RabidRabbit2019/quaz/README.md

# quaz
test project, based on bluepill board
