RabidRabbit2019/quaz/quaz_amp_part/report.txt

Заменить посад.место C7 с 'Capacitor_Tantalum_SMD:CP_EIA-3528-21_Kemet-B_Pad1.50x2.35mm_HandSolder' на 'Capacitor_Tantalum_SMD:CP_EIA-6032-28_Kemet-C_Pad2.25x2.35mm_HandSolder': OK
