RabidRabbit2019/quaz/quaz_btn_part/quaz_btn_part.kicad_pcb

## KiCad design quaz_btn_part/quaz_btn_part.kicad_pcb (2024-06-14)

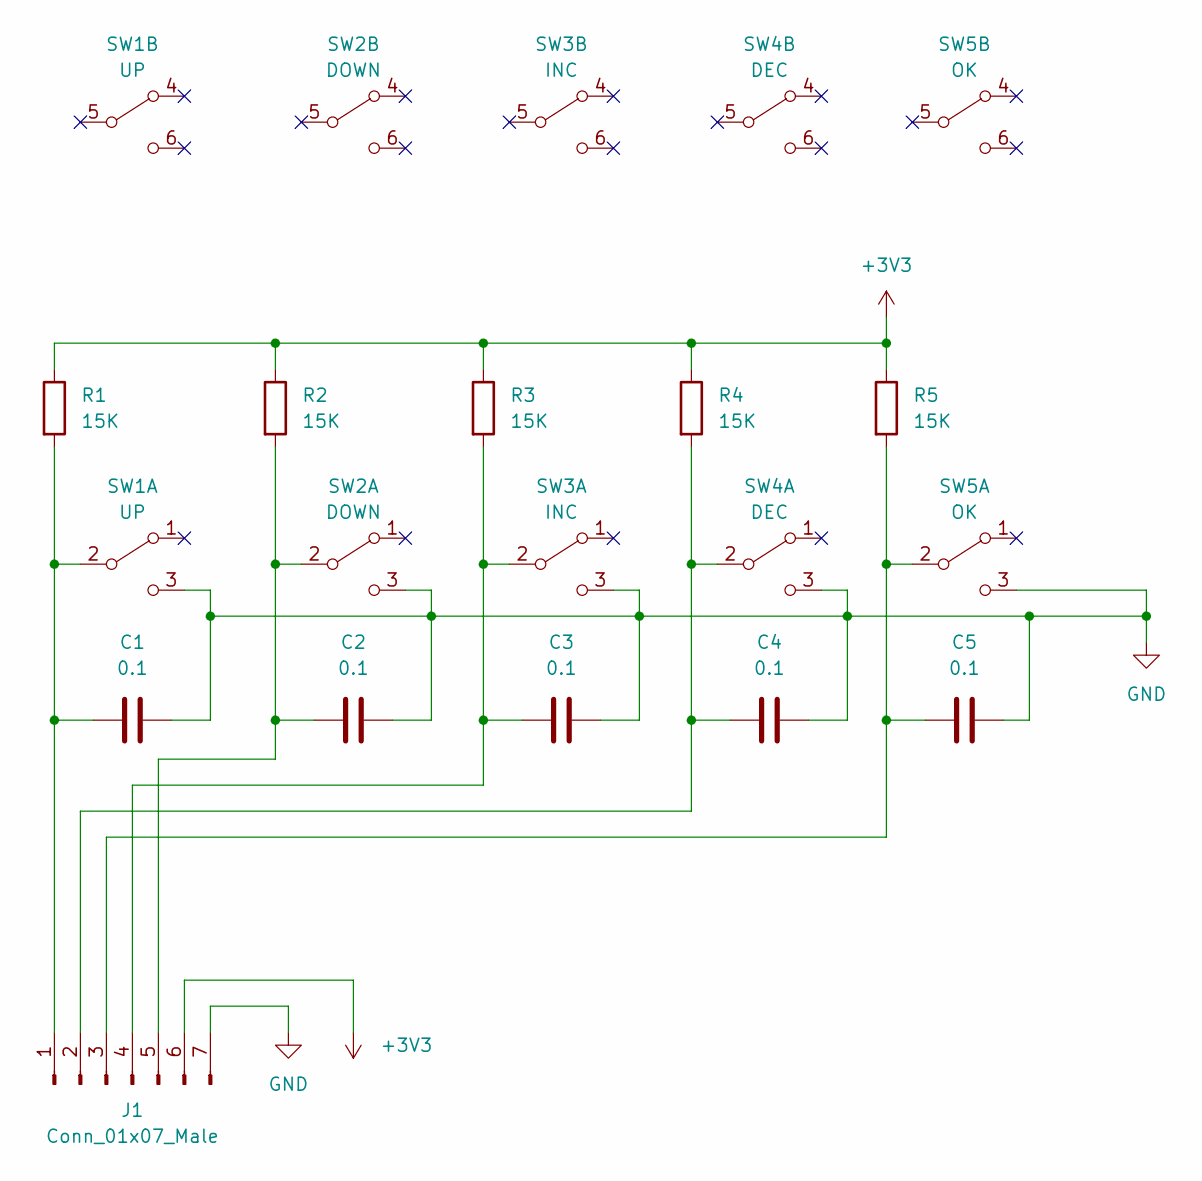
[picture p1: schematic quaz_btn_part.kicad_sch]

Parts:
C1, C2, C3, C4, C5: 0.1; C_1206_3216Metric_Pad1.33x1.80mm_HandSolder
J1: Conn_01x07_Male; PinHeader_1x07_P2.54mm_Vertical
R1, R2, R3, R4, R5: 15K; R_1206_3216Metric_Pad1.30x1.75mm_HandSolder
SW1: UP; BTN13
SW2: DOWN; BTN13
SW3: INC; BTN13
SW4: DEC; BTN13
SW5: OK; BTN13

Connections:
+3V3: J1.6, R1.1, R2.1, R3.1, R4.1, R5.1
GND: C1.2, C2.2, C3.2, C4.2, C5.2, J1.7, SW1.3 (C), SW2.3 (C), SW3.3 (C), SW4.3 (C), SW5.3 (C)
unnamed: C2.1, J1.5, R2.2, SW2.2 (B)
unnamed: C3.1, J1.4, R3.2, SW3.2 (B)
unnamed: C4.1, J1.2, R4.2, SW4.2 (B)
unnamed: C5.1, J1.3, R5.2, SW5.2 (B)
unnamed: C1.1, J1.1, R1.2, SW1.2 (B)

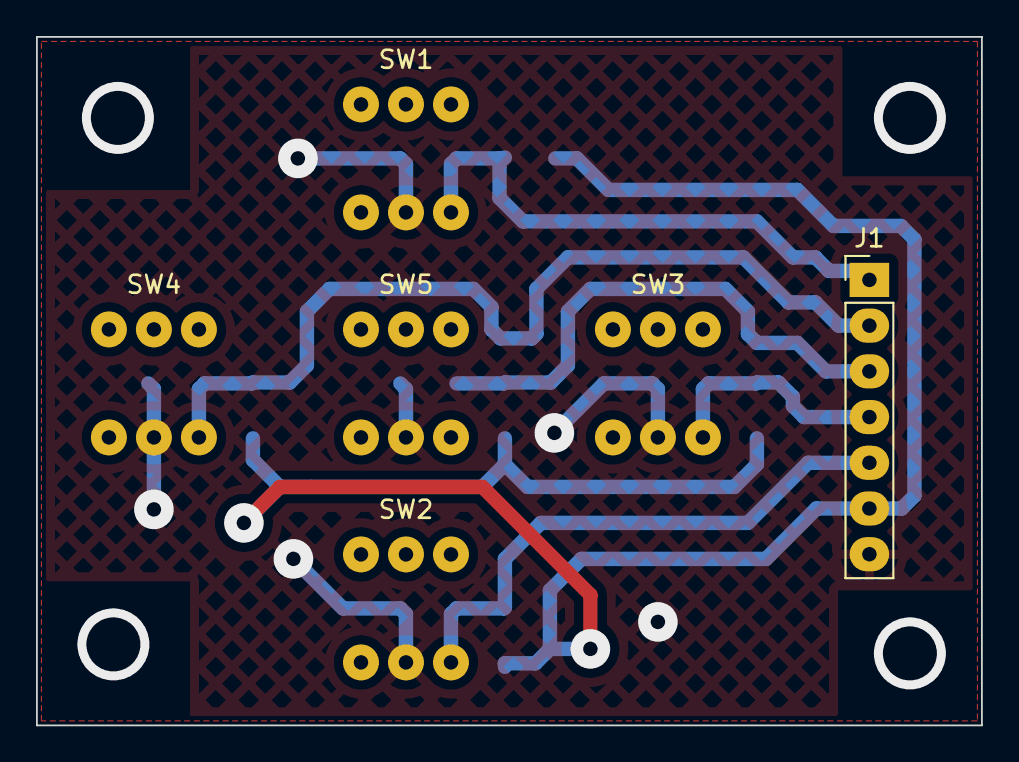
[picture p2: board quaz_btn_part.kicad_pcb from above]

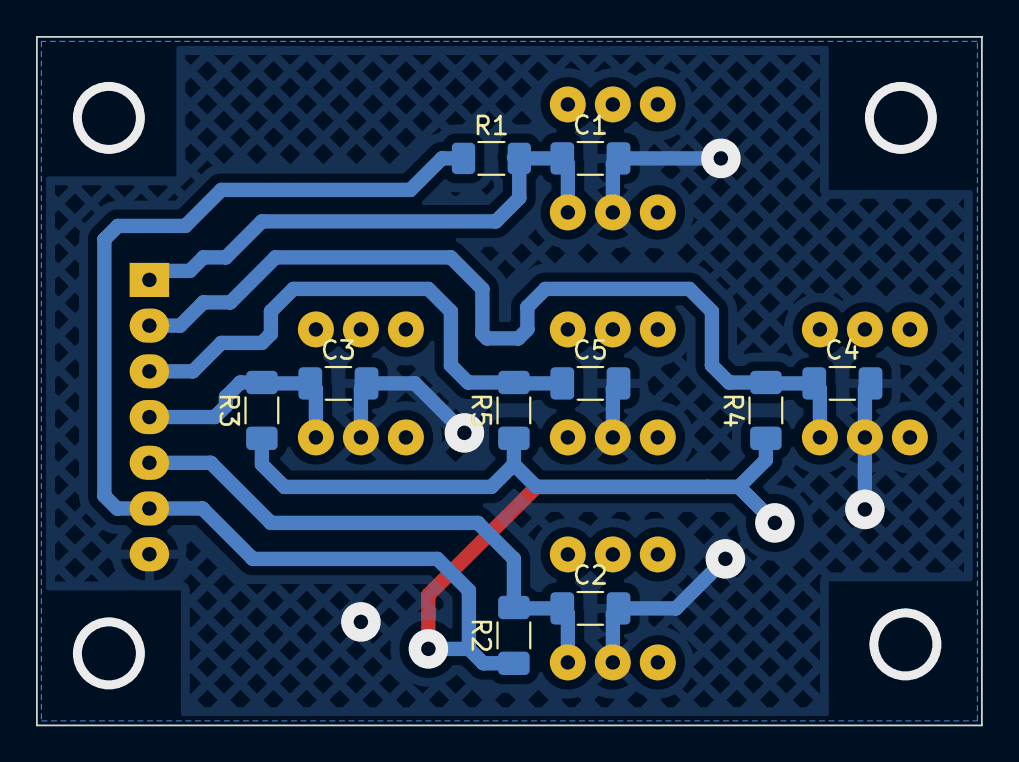
[picture p3: board quaz_btn_part.kicad_pcb from below]

Board: 2 copper layers, 52.5 x 38.2 mm, 16 parts (10 on the bottom side), 7 nets.
