RabidRabbit2019/quaz/quaz_drv_part/quaz_drv_part.kicad_pcb

## KiCad design quaz_drv_part/quaz_drv_part.kicad_pcb (2024-05-04)

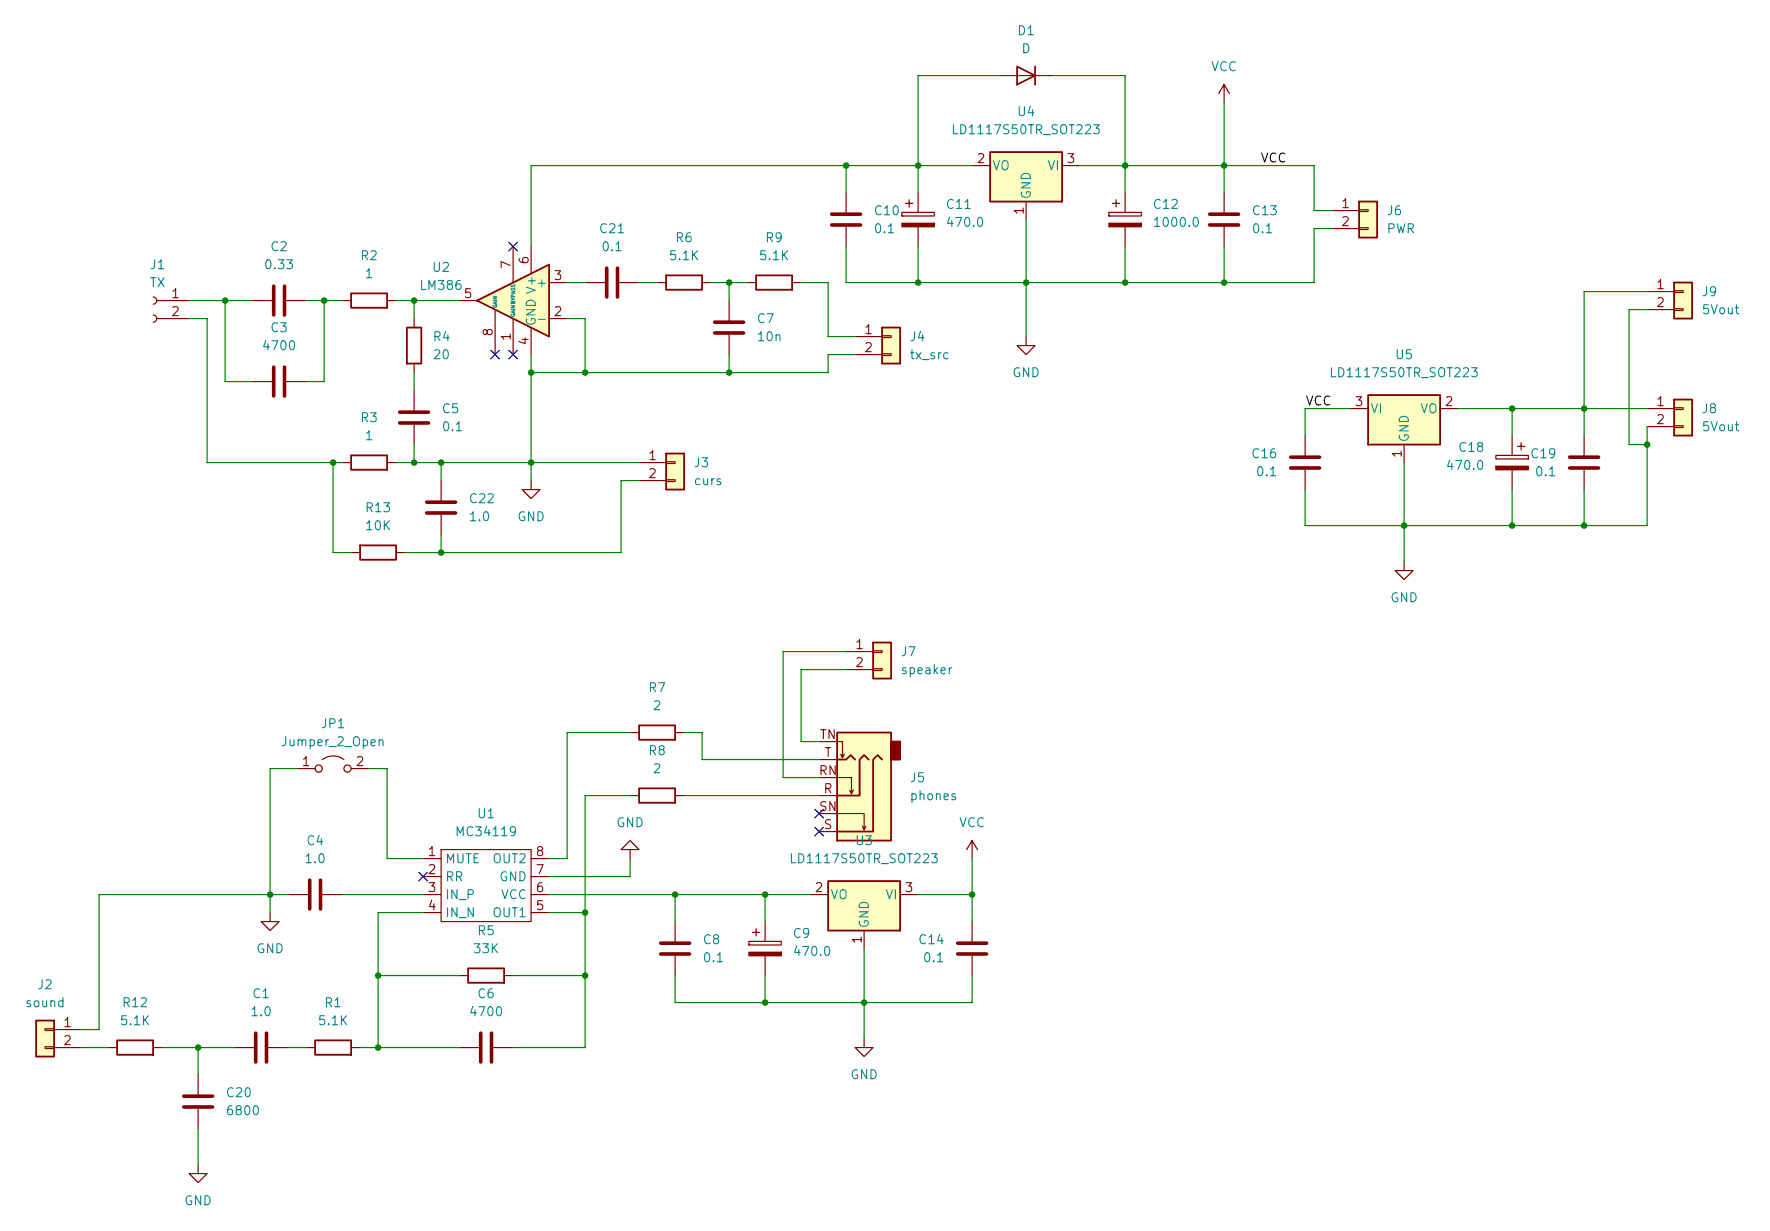
[picture p4: schematic quaz_drv_part.kicad_sch]

Parts:
C1, C4, C22: 1.0; C_1206_3216Metric_Pad1.33x1.80mm_HandSolder
C2: 0.33; C_Disc_D9.0mm_W5.0mm_P5.00mm
C3, C6: 4700; C_Disc_D9.0mm_W5.0mm_P5.00mm
C5, C8, C10, C13, C14, C16, C19, C21: 0.1; C_1206_3216Metric_Pad1.33x1.80mm_HandSolder
C7: 10n; C_Disc_D9.0mm_W5.0mm_P5.00mm
C9: 470.0; CP_Radial_D8.0mm_P5.00mm
C11, C18: 470.0; CP_Radial_D10.0mm_P5.00mm
C12: 1000.0; CP_Radial_D10.0mm_P5.00mm
C20: 6800; C_Disc_D9.0mm_W5.0mm_P5.00mm
D1: D; D_DO-41_SOD81_P5.08mm_Vertical_KathodeUp
J1: TX; PinHeader_1x02_P2.54mm_Vertical
J2: sound; PinHeader_1x02_P2.54mm_Vertical
J3: curs; PinHeader_1x02_P2.54mm_Vertical
J4: tx_src; PinHeader_1x02_P2.54mm_Vertical
J5: phones; Jack_6.35mm_Neutrik_NMJ6HCD3_Horizontal
J6: PWR; PinHeader_1x02_P2.54mm_Vertical
J7: speaker; PinHeader_1x02_P2.54mm_Vertical
J8, J9: 5Vout; PinHeader_1x02_P2.54mm_Vertical
JP1: Jumper_2_Open; PinHeader_1x02_P2.54mm_Vertical
R1, R6, R9, R12: 5.1K; R_1206_3216Metric_Pad1.30x1.75mm_HandSolder
R2, R3: 1; R_Axial_Power_L20.0mm_W6.4mm_P7.62mm_Vertical
R4: 20; R_Axial_DIN0207_L6.3mm_D2.5mm_P5.08mm_Vertical
R5: 33K; R_1206_3216Metric_Pad1.30x1.75mm_HandSolder
R7, R8: 2; R_1206_3216Metric_Pad1.30x1.75mm_HandSolder
R13: 10K; R_1206_3216Metric_Pad1.30x1.75mm_HandSolder
U1: MC34119; SOIC-8_3.9x4.9mm_P1.27mm
U2: LM386; DIP-8_W7.62mm
U3, U4, U5: LD1117S50TR_SOT223; SOT-223-3_TabPin2

Connections:
GND: C4.1, C5.2, C7.2, C8.2, C9.2, C10.2, C11.2, C12.2, C13.2, C14.2, C16.2, C18.2, C19.2, C20.2, C22.2, J2.1, J3.1, J4.2, J6.2, J8.2, J9.2, JP1.1 (A), R3.2, U1.7 (GND), U2.2 (-), U2.4 (GND), U3.1 (GND), U4.1 (GND), U5.1 (GND)
unnamed: C1.1, C20.1, R12.2
unnamed: C1.2, R1.1
unnamed: C2.1, C3.1, J1.1
unnamed: C2.2, C3.2, R2.1
unnamed: C4.2, U1.3 (IN_P)
unnamed: C5.1, R4.2
unnamed: C6.1, R5.2, R8.1, U1.5 (OUT1)
unnamed: C6.2, R1.2, R5.1, U1.4 (IN_N)
unnamed: C7.1, R6.1, R9.1
unnamed: C8.1, C9.1, U1.6 (VCC), U3.2 (VO)
unnamed: C10.1, C11.1, D1.2 (A), U2.6 (V+), U4.2 (VO)
unnamed: C18.1, C19.1, J8.1, J9.1, U5.2 (VO)
unnamed: C21.1, U2.3 (+)
unnamed: C21.2, R6.2
unnamed: C22.1, J3.2, R13.1
unnamed: J1.2, R3.1, R13.2
unnamed: J2.2, R12.1
unnamed: J4.1, R9.2
unnamed: J5.R, R8.2
unnamed: J5.RN, J7.1
unnamed: J5.T, R7.2
unnamed: J5.TN, J7.2
unnamed: JP1.2 (B), U1.1 (MUTE)
unnamed: R2.2, R4.1, U2.5
unnamed: R7.1, U1.8 (OUT2)
VCC: C12.1, C13.1, C14.1, C16.1, D1.1 (K), J6.1, U3.3 (VI), U4.3 (VI), U5.3 (VI)

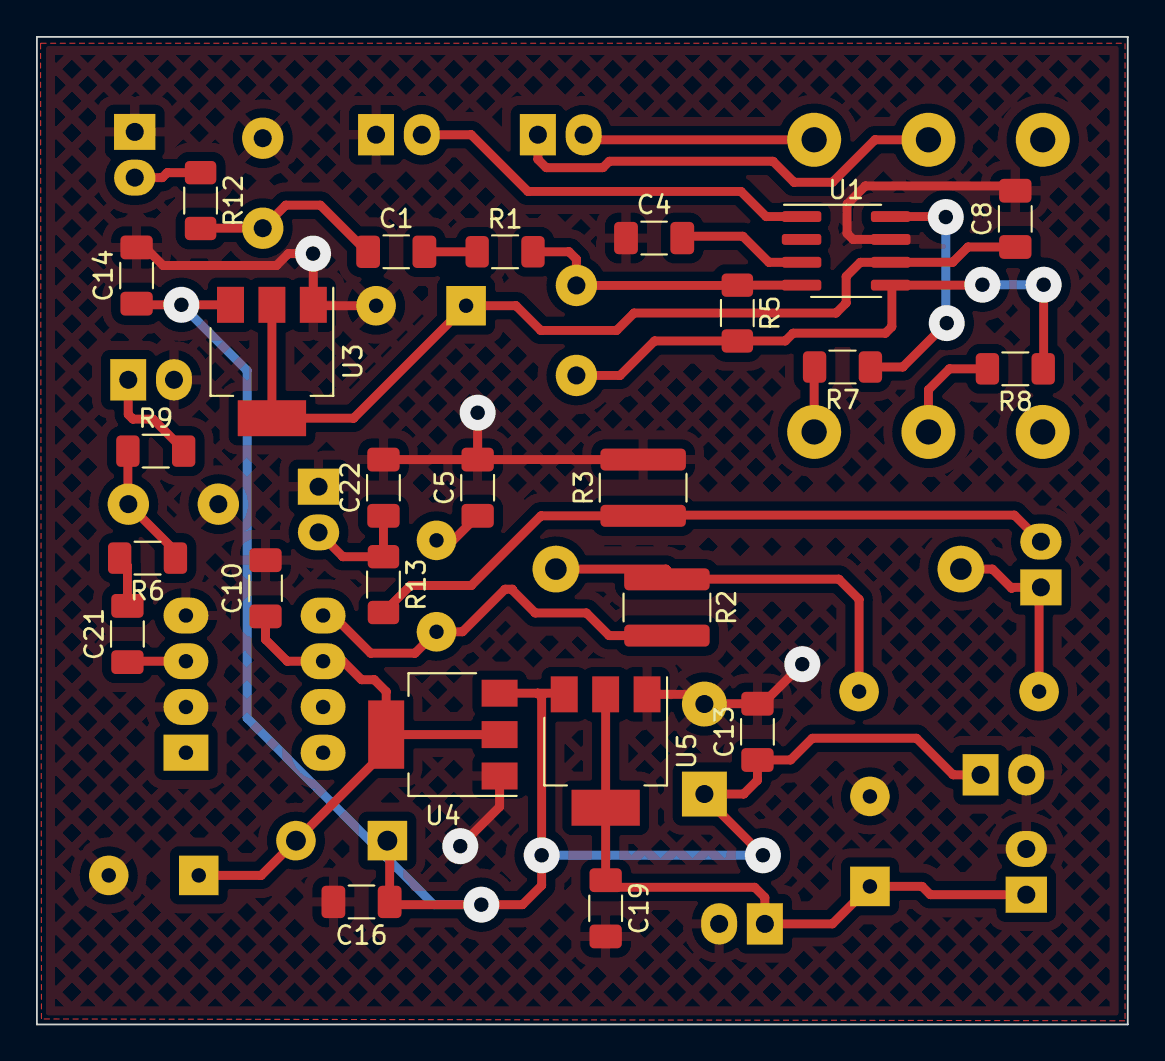
[picture p5: board quaz_drv_part.kicad_pcb from above]

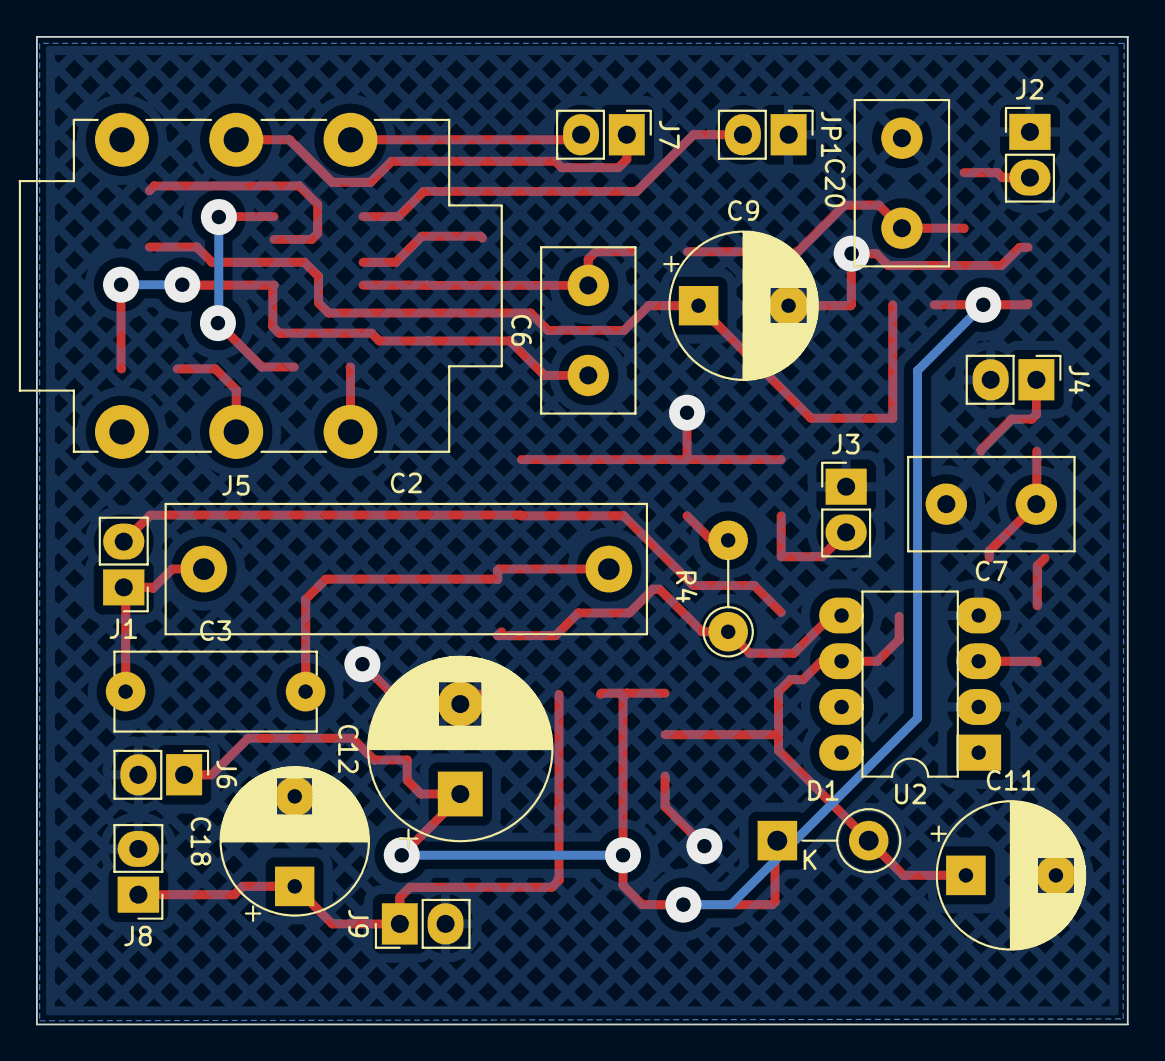
[picture p6: board quaz_drv_part.kicad_pcb from below]

Board: 2 copper layers, 60.6 x 54.9 mm, 47 parts (22 on the bottom side), 27 nets.
