RabidRabbit2019/quaz/quaz_amp_part/quaz_amp_part.kicad_pcb

## KiCad design quaz_amp_part/quaz_amp_part.kicad_pcb (2024-04-10)

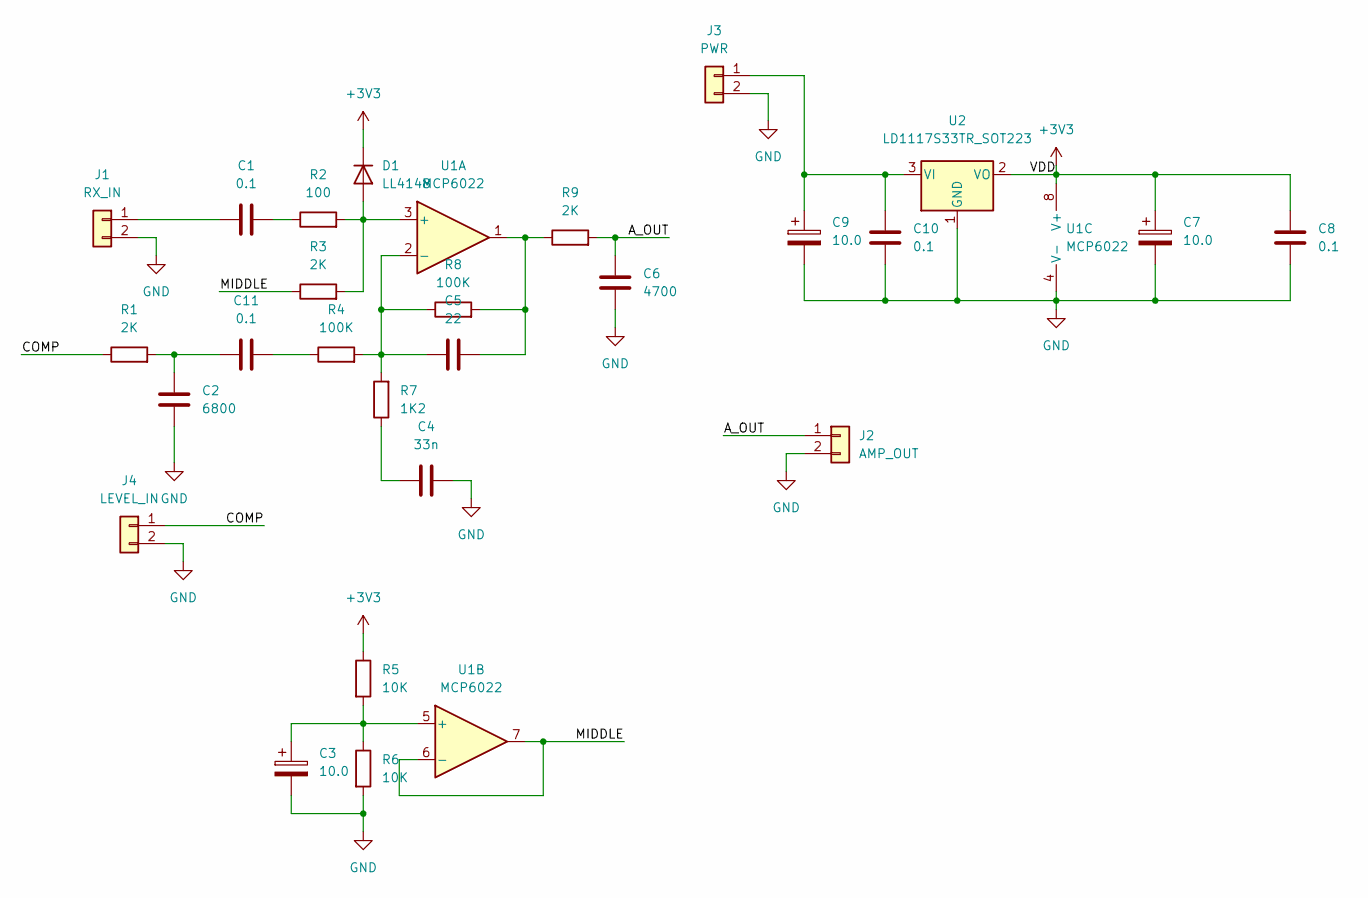
[picture p7: schematic quaz_amp_part.kicad_sch]

Parts:
C1, C8, C10, C11: 0.1; C_1206_3216Metric_Pad1.33x1.80mm_HandSolder
C2: 6800; C_Disc_D3.4mm_W2.1mm_P2.50mm
C3: 10.0; CP_EIA-7132-28_AVX-C_Pad2.72x3.50mm_HandSolder
C4: 33n; C_Disc_D8.0mm_W2.5mm_P5.00mm
C5: 22; C_Disc_D8.0mm_W2.5mm_P5.00mm
C6: 4700; C_Disc_D3.4mm_W2.1mm_P2.50mm
C7, C9: 10.0; CP_EIA-7132-20_AVX-U_Pad2.72x3.50mm_HandSolder
D1: LL4148; D_1206_3216Metric_Pad1.42x1.75mm_HandSolder
J1: RX_IN; PinHeader_1x02_P2.54mm_Vertical
J2: AMP_OUT; PinHeader_1x02_P2.54mm_Vertical
J3: PWR; PinHeader_1x02_P2.54mm_Vertical
J4: LEVEL_IN; PinHeader_1x02_P2.54mm_Vertical
R1, R3, R9: 2K; R_1206_3216Metric_Pad1.30x1.75mm_HandSolder
R2: 100; R_1206_3216Metric_Pad1.30x1.75mm_HandSolder
R4, R8: 100K; R_1206_3216Metric_Pad1.30x1.75mm_HandSolder
R5, R6: 10K; R_1206_3216Metric_Pad1.30x1.75mm_HandSolder
R7: 1K2; R_1206_3216Metric_Pad1.30x1.75mm_HandSolder
U1: MCP6022; SOIC-8_3.9x4.9mm_P1.27mm
U2: LD1117S33TR_SOT223; SOT-223-3_TabPin2

Connections:
+3V3: C7.1, C8.1, D1.1 (K), R5.1, U1.8 (V+), U2.2 (VO)
/A_OUT: C6.2, J2.1, R9.2
/COMP: J4.1, R1.1
/MIDDLE: R3.1, U1.6 (-), U1.7
GND: C2.2, C3.2, C4.2, C6.1, C7.2, C8.2, C9.2, C10.2, J1.2, J2.2, J3.2, J4.2, R6.2, U1.4 (V-), U2.1 (GND)
unnamed: C1.1, J1.1
unnamed: C1.2, R2.1
unnamed: C2.1, C11.1, R1.2
unnamed: C3.1, R5.2, R6.1, U1.5 (+)
unnamed: C4.1, R7.1
unnamed: C5.1, R4.2, R7.2, R8.1, U1.2 (-)
unnamed: C5.2, R8.2, R9.1, U1.1
unnamed: C9.1, C10.1, J3.1, U2.3 (VI)
unnamed: D1.2 (A), R2.2, R3.2, U1.3 (+)
unnamed: C11.2, R4.1

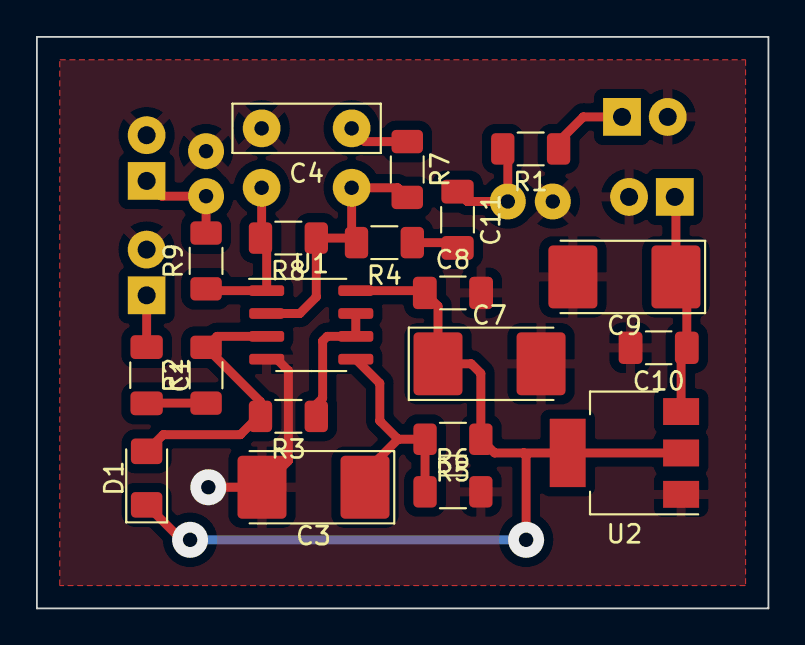
[picture p8: board quaz_amp_part.kicad_pcb from above]

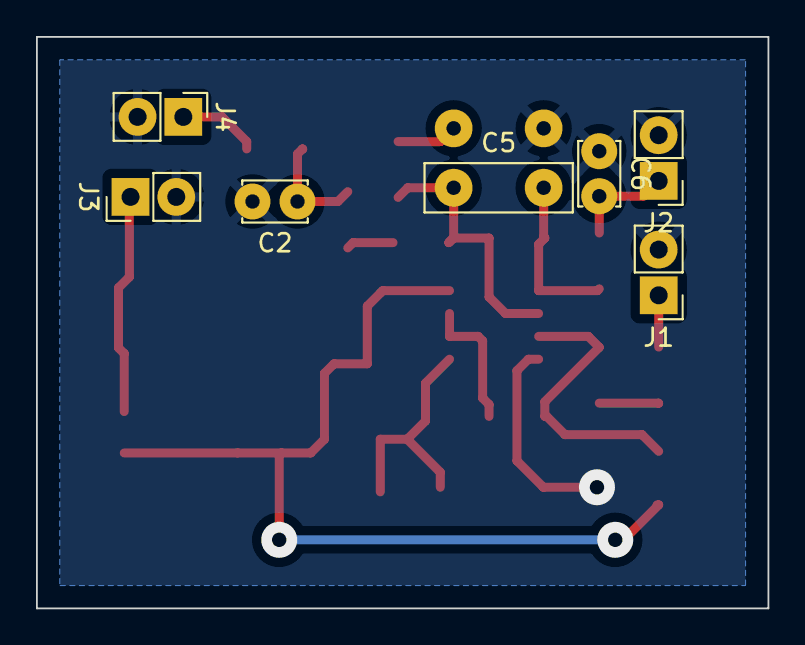
[picture p9: board quaz_amp_part.kicad_pcb from below]

Board: 2 copper layers, 40.6 x 31.8 mm, 27 parts (7 on the bottom side), 15 nets.
