RabidRabbit2019/quaz/src/gen_dds.c

#include "gen_dds.h"
#include "settings.h"
#include "stm32f103x6.h"


void delay_ms( uint32_t a_ms );

// dds генераторы для TX, компенсации разбаланса и звука

// ширина импульсов для косинуса, 256 уровней
static const uint8_t g_cos_table[1024] = {
128, 129, 130, 130, 131, 132, 133, 133,
134, 135, 136, 137, 137, 138, 139, 140,
140, 141, 142, 143, 144, 144, 145, 146,
147, 147, 148, 149, 150, 151, 151, 152,
153, 154, 154, 155, 156, 157, 157, 158,
159, 160, 160, 161, 162, 163, 164, 164,
165, 166, 167, 167, 168, 169, 169, 170,
171, 172, 172, 173, 174, 175, 175, 176,
177, 178, 178, 179, 180, 180, 181, 182,
183, 183, 184, 185, 185, 186, 187, 187,
188, 189, 189, 190, 191, 192, 192, 193,
194, 194, 195, 196, 196, 197, 198, 198,
199, 199, 200, 201, 201, 202, 203, 203,
204, 205, 205, 206, 206, 207, 208, 208,
209, 209, 210, 211, 211, 212, 212, 213,
214, 214, 215, 215, 216, 216, 217, 218,
218, 219, 219, 220, 220, 221, 221, 222,
222, 223, 224, 224, 225, 225, 226, 226,
227, 227, 228, 228, 229, 229, 229, 230,
230, 231, 231, 232, 232, 233, 233, 234,
234, 234, 235, 235, 236, 236, 237, 237,
237, 238, 238, 239, 239, 239, 240, 240,
240, 241, 241, 242, 242, 242, 243, 243,
243, 244, 244, 244, 245, 245, 245, 245,
246, 246, 246, 247, 247, 247, 248, 248,
248, 248, 249, 249, 249, 249, 250, 250,
250, 250, 250, 251, 251, 251, 251, 251,
252, 252, 252, 252, 252, 253, 253, 253,
253, 253, 253, 253, 254, 254, 254, 254,
254, 254, 254, 254, 255, 255, 255, 255,
255, 255, 255, 255, 255, 255, 255, 255,
255, 255, 255, 255, 255, 255, 255, 255,
255, 255, 255, 255, 255, 255, 255, 255,
255, 255, 255, 255, 255, 255, 255, 255,
255, 255, 255, 255, 255, 254, 254, 254,
254, 254, 254, 254, 254, 253, 253, 253,
253, 253, 253, 253, 252, 252, 252, 252,
252, 251, 251, 251, 251, 251, 250, 250,
250, 250, 250, 249, 249, 249, 249, 248,
248, 248, 248, 247, 247, 247, 246, 246,
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
};


// текущая фаза генератора TX
static uint32_t g_phase_tx = 0;
// текущая фаза генератора компенсации разбаланса
static volatile uint32_t g_phase_comp = 0;
// текущая фаза генератора звука
static uint32_t g_phase_sound = 0;
// уровень выходного сигнала TX [0..256]
static volatile uint32_t g_level_tx = 0;
// уровень выходного сигнала компенсации разбаланса [0..256]
static volatile uint32_t g_level_comp = 0;
// уровень громкости звука [0...256]
static volatile uint32_t g_level_sound = 0;
// частота (сдвиг фазы генератора) TX и сигнала компенсации
static uint32_t g_gen_freq = 0;
// частота (сдвиг фазы генератора) звука
static uint32_t g_sound_freq = 0;


uint32_t get_tx_phase() {
  return g_phase_tx;
}


uint32_t get_tx_freq() {
  return g_gen_freq;
}


void set_sound_freq_by_angle( uint32_t a_angle ) {
  g_sound_freq = 512u + (uint32_t)( ((((uint64_t)a_angle) * 10) << 32) / BASE_PWM_FREQ );
}


uint32_t get_tx_level() {
  return g_level_tx;
}


uint32_t get_cm_level() {
  return g_level_comp;
}


void set_tx_level( uint32_t a_level ) {
  if ( a_level > MAX_TX_LEVEL ) {
    a_level = MAX_TX_LEVEL;
  } else {
    if ( a_level < MIN_TX_LEVEL ) {
      a_level = MIN_TX_LEVEL;
    }
  }
  g_level_tx = a_level;
}


void set_cm_level( uint32_t a_level ) {
  if ( a_level > MAX_TX_LEVEL ) {
    a_level = MAX_TX_LEVEL;
  } else {
    if ( a_level < MIN_TX_LEVEL ) {
      a_level = MIN_TX_LEVEL;
    }
  }
  g_level_comp = a_level;
}


// установить громкость звука
void set_sound_volume( uint32_t a_volume ) {
  if ( a_volume > MAX_SOUND_VOLUME ) {
    a_volume = MAX_SOUND_VOLUME;
  } else {
    if ( a_volume < MIN_SOUND_VOLUME ) {
      a_volume = MIN_SOUND_VOLUME;
    }
  }
  g_level_sound = a_volume;
}


// изменить текущую фазу сигнала компенсации
void set_cm_phase( uint32_t a_phase_diff ) {
  // запоминаем текущую фазу генератора
  uint32_t v_phase = g_phase_comp;
  // ждём изменения фазы генератора (сгенерирован очередной отсчёт)
  while ( v_phase == g_phase_comp ) {}
  // меняем фазу генератора между отсчётами
  g_phase_comp += a_phase_diff;
}


// настройка таймера-1
// канал 1 - генерация "синуса" для TX
// канал 2 - генерация "синуса" для сигнала компенсации
// канал 3 - генерация "синуса" для звука
// настройка таймера-3 - генерация "пинков" для АЦП (cобытие сравнения 2 раза за период)
void gen_dds_init() {
  // настройки генераторов из профиля
  settings_t * v_profile = settings_get_current_profile();
  g_level_tx = v_profile->level_tx; // по базовой схеме ~60 мА
  g_level_comp = v_profile->level_comp;
  g_level_sound = v_profile->level_sound;
  g_gen_freq = v_profile->gen_freq;
  g_phase_comp = v_profile->phase_comp_start;
  // включаем выводы каналов CH1/PA8, CH2/PA9, CH3/PA11 таймера-1
  // alternate push-pull 2MHz
  GPIOA->CRH = (GPIOA->CRH & ~( GPIO_CRH_MODE8_Msk | GPIO_CRH_CNF8_Msk
                              | GPIO_CRH_MODE9_Msk | GPIO_CRH_CNF9_Msk
                              | GPIO_CRH_MODE10_Msk | GPIO_CRH_CNF10_Msk
                              ))
               | GPIO_CRH_MODE8_1  | GPIO_CRH_CNF8_1
               | GPIO_CRH_MODE9_1  | GPIO_CRH_CNF9_1
               | GPIO_CRH_MODE10_1 | GPIO_CRH_CNF10_1
               ;
  // настраиваем таймер-1
  // тактируется от APB2 без делителя (72МГц), двунаправленный счётчик, APR=256, период 512 тактов
  // ШИМ 8 битов (частота 72000000 / 512 = 140625). Update Event один раз за период, т.е. RCR=1
  // Output Trigger по включению таймера для одновременного запуска TIM3
  TIM1->PSC = 0; // без делителя
  TIM1->ARR = 256; // докуда считать
  TIM1->RCR = 1; // "делитель" частоты Update Event
  TIM1->CNT = 0; // на всяк случ сброс счётчика
  TIM1->CCR1 = g_cos_table[0]; // TX начинаем с нулевой фазы
  // сигнал компенсации по фазе от g_phase_comp, может быть прочитано из профиля и != 0
  // 1024 отсчёта - период "синусоиды", 2^32 - период фазы генератора (DDS)
  TIM1->CCR2 = g_cos_table[g_phase_comp >> 22];
  TIM1->CCR3 = g_cos_table[0]; // звук, с нулевой фазы, тут пофик
  // режимы сравнения для трёх каналов
  TIM1->CCMR1 = TIM_CCMR1_OC1M_1 | TIM_CCMR1_OC1M_2 | TIM_CCMR1_OC1PE
              | TIM_CCMR1_OC2M_1 | TIM_CCMR1_OC2M_2 | TIM_CCMR1_OC2PE
              ;
  TIM1->CCMR2 = TIM_CCMR2_OC3M_1 | TIM_CCMR2_OC3M_2 | TIM_CCMR2_OC3PE
              ;
  TIM1->CCER = TIM_CCER_CC1E
             | TIM_CCER_CC2E
             | TIM_CCER_CC3E
             ;
  TIM1->BDTR = TIM_BDTR_MOE
             | TIM_BDTR_OSSR
             ;
  TIM1->CR2 = TIM_CR2_MMS_0; // запуск таймера - событие TRGO
  TIM1->CR1 = TIM_CR1_CMS_0 | TIM_CR1_CMS_1
            | TIM_CR1_URS
            ;
  TIM1->SR = 0;
  TIM1->DIER = TIM_DIER_UIE;
  // настраиваем таймер-3 для пинания АЦП, тактирование 36 МГц (APB1 без делителя)
  // счёт вверх до 127 (0..127, 128 тактов), запуск синхронно со стартом TIM1
  TIM3->PSC = 0;
  TIM3->CR1 = TIM_CR1_URS;
  TIM3->CR2 = TIM_CR2_MMS_1;
  TIM3->ARR = 127;
  TIM3->CNT = 0;
  TIM3->SMCR = TIM_SMCR_SMS_1
             | TIM_SMCR_SMS_2
             ;
  // запускаем TIM1 и TIM3
  TIM1->CR1 |= TIM_CR1_CEN;
  __NVIC_EnableIRQ( TIM1_UP_IRQn );
  // генерируем Update Event, чтобы в "теневые" регистры попали текущие значения
  // а в буферные регистры легли новые значения (для следующего периода)
  // TIM1->EGR = TIM_EGR_UG;
}


void gen_dds_shutdown() {
  // отключаем прерывание от таймера
  __NVIC_DisableIRQ( TIM1_UP_IRQn );
  // отключаем таймер 3
  TIM3->CR1 = 0;
  // отключаем таймер 1
  TIM1->CR1 = 0;
  // сброс таймеров 1 и 3
  RCC->APB1RSTR = RCC_APB1RSTR_TIM3RST;
  RCC->APB2RSTR = RCC_APB2RSTR_TIM1RST;
  delay_ms( 2u );
  RCC->APB1RSTR = 0;
  RCC->APB2RSTR = 0;
  // начальные значения переменных
  g_phase_tx = 0;
  g_phase_comp = 0;
  g_phase_sound = 0;
  g_level_tx = 0;
  g_level_comp = 0;
  g_level_sound = 0;
  g_gen_freq = 0;
  g_sound_freq = 0;
}


// событие update таймера-1, обновляем регистры сравнения
// эти значения перепишутся в "теневые" регистры при следующем Update Event
void ih_TIM1_UP_IRQ() {
  // подвинем фазу
  g_phase_tx += g_gen_freq;
  // значение косинуса берём из таблицы
  TIM1->CCR1 = (g_cos_table[g_phase_tx >> 22] * g_level_tx) >> 12;
  // подвинем фазу
  g_phase_comp += g_gen_freq;
  // значение косинуса из таблицы
  TIM1->CCR2 = (g_cos_table[g_phase_comp >> 22] * g_level_comp) >> 12;
  // подвинем фазу
  g_phase_sound += g_sound_freq;
  // значение косинуса из таблицы
  TIM1->CCR3 = (g_cos_table[g_phase_sound >> 22] * g_level_sound) >> 12;
  // сбрасываем флаги прерывания
  TIM1->SR = 0;
}
