RabidRabbit2019/quaz/src/gen_dds.h

#ifndef __GEN_DDS_H__
#define __GEN_DDS_H__

#include <stdint.h>


#define BASE_PWM_FREQ       (72000000/512)

#define MAX_SOUND_VOLUME    2048u
#define MIN_SOUND_VOLUME    10u

#define MAX_TX_LEVEL        2048u
#define MIN_TX_LEVEL        10u

#define MAX_CM_LEVEL        2048u
#define MIN_CM_LEVEL        1u


void gen_dds_init();
void gen_dds_shutdown();
uint32_t get_tx_phase();
uint32_t get_tx_freq();
void set_sound_freq_by_angle( uint32_t a_angle );
void set_sound_volume( uint32_t a_volume );
uint32_t get_tx_level();
void set_tx_level( uint32_t a_level );
uint32_t get_cm_level();
void set_cm_level( uint32_t a_level );
void set_cm_phase( uint32_t a_phase_diff );

#endif // __GEN_DDS_H__
