RabidRabbit2019/quaz/(commit log)

2024-03-18 initial, dds works
    [stm32f1x.cfg]
2024-03-19 adc double buffered
    [stm32f1x.cfg]
2024-03-25 attach display test
2024-03-29 add kicad sources
    [quaz_amp_part.kicad_pcb, quaz_amp_part.kicad_sch, quaz_conn_part.kicad_pcb, quaz_conn_part.kicad_sch, quaz_drv_part.kicad_pcb, quaz_drv_part.kicad_sch]
2024-04-01 buttons, gui
    [quaz_conn_part.kicad_sch]
2024-04-15 drv layout change
    [quaz_drv_part.kicad_pcb]
2024-04-19 add btn_part
    [quaz_btn_part.kicad_pcb, quaz_btn_part.kicad_sch, quaz_drv_part.kicad_pcb]
2024-04-25 add menu nav
    [quaz_btn_part.kicad_sch]
2024-05-04 add current sens
    [quaz_conn_part.kicad_sch, quaz_drv_part.kicad_pcb]
2024-05-06 fix buttons
2024-05-07 add buttons board
    [quaz_btn_part.kicad_pcb, quaz_btn_part.kicad_sch]
2024-05-15 add some settings
    [quaz_conn_part.kicad_sch, quaz_drv_part.kicad_sch]
2024-06-14 pcb for buttons
    [quaz_btn_part.kicad_pcb]
2024-10-23 добавлены настройки вольтметра
2024-12-25 комментарии, новая версия файла stm32f103x6.h
2024-12-29 рефакторинг
2024-12-29 добавлена обработка интерфейса калибровки
